lhr-solar/PS-PumpController/readme.md

# PTN-PumpControlBoard
This PCB provides an interface to control the speed of a 12V pump for battery cooling on the 2026 LHR Solar car.
