lhr-solar/PS-PumpController/hardware/PumpController-lib/3d/NVMFWS1D7N04XMT1G.stp

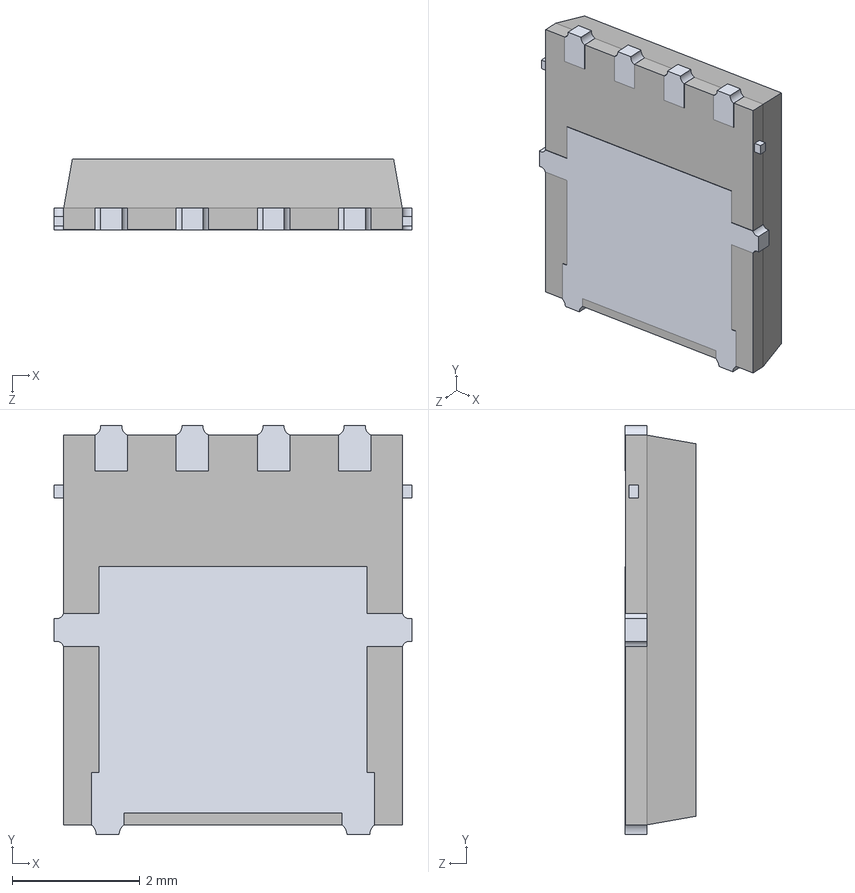
[picture p1: CAD file, 2026-02-16]
hardware/PumpController-lib/3d/NVMFWS1D7N04XMT1G.stp
5.60 x 6.40 x 1.11 mm
