lhr-solar/PS-PumpController/hardware/PumpController-lib/3d/Nano-Fit_2x07_P2.50mm_Vertical.stp

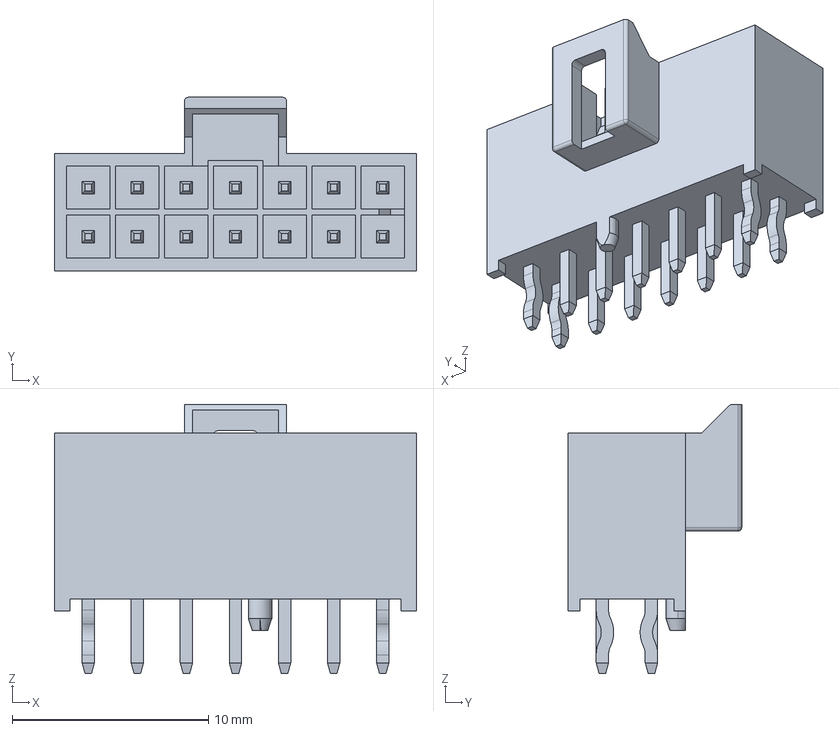
[picture p2: CAD file, 2026-02-16]
hardware/PumpController-lib/3d/Nano-Fit_2x07_P2.50mm_Vertical.stp
18.4 x 8.84 x 13.7 mm
