lhr-solar/PS-PumpController/hardware/PumpController-lib/3d/EMC2305-1-AP-TR.stp

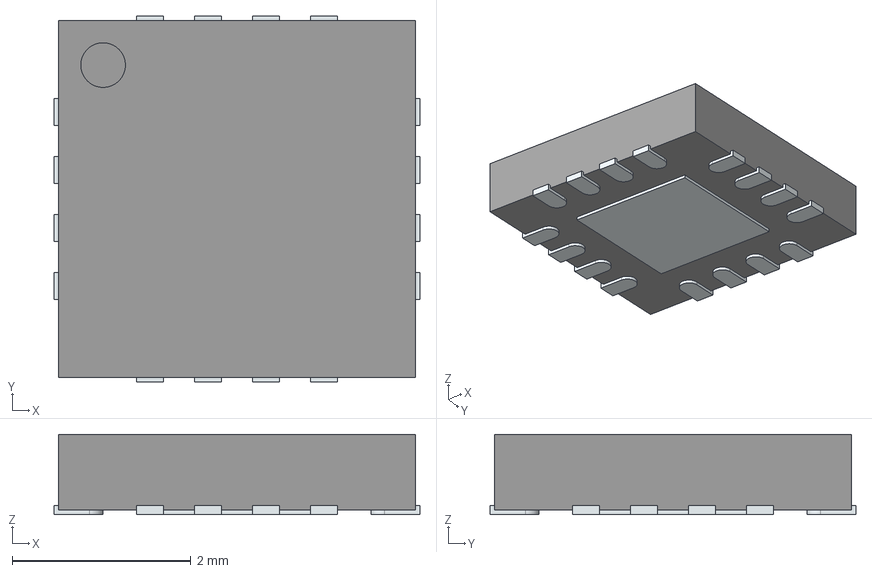
[picture p3: CAD file, 2026-02-16]
hardware/PumpController-lib/3d/EMC2305-1-AP-TR.stp
4.10 x 4.10 x 0.9 mm
ThermalPin
PinsArrayLR
PinsArrayTB
