lhr-solar/PS-PumpController/hardware/PumpController-lib/3d/Nano-Fit_2x03_P2.50mm_Vertical.stp

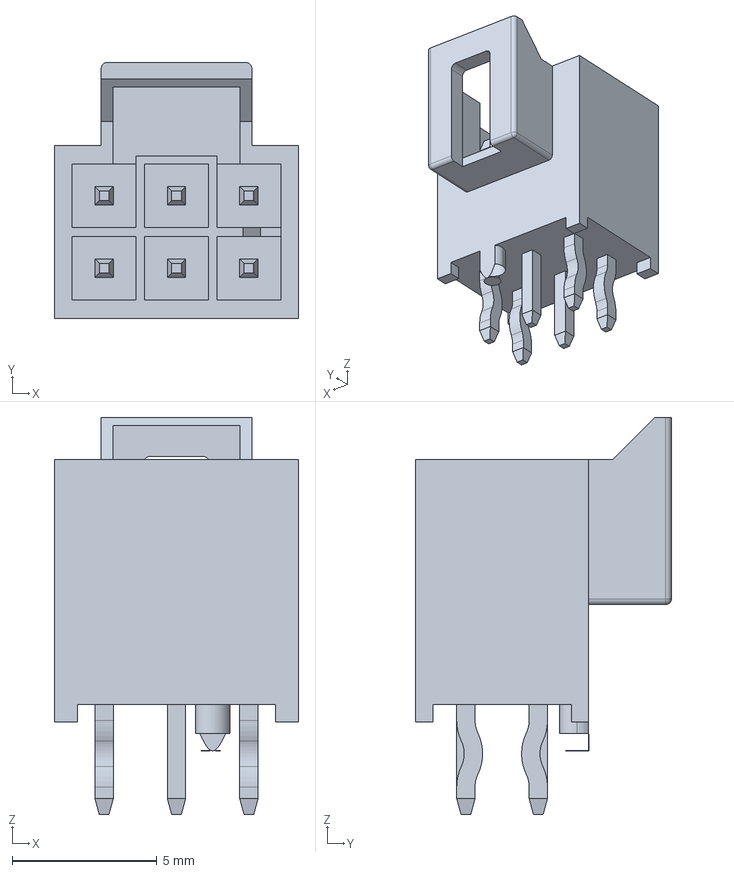
[picture p4: CAD file, 2026-01-15]
hardware/PumpController-lib/3d/Nano-Fit_2x03_P2.50mm_Vertical.stp
8.44 x 8.84 x 13.7 mm
