lhr-solar/PS-PumpController/hardware/PumpController-lib/3d/Nano-Fit_2x06_P2.50mm_Vertical.stp

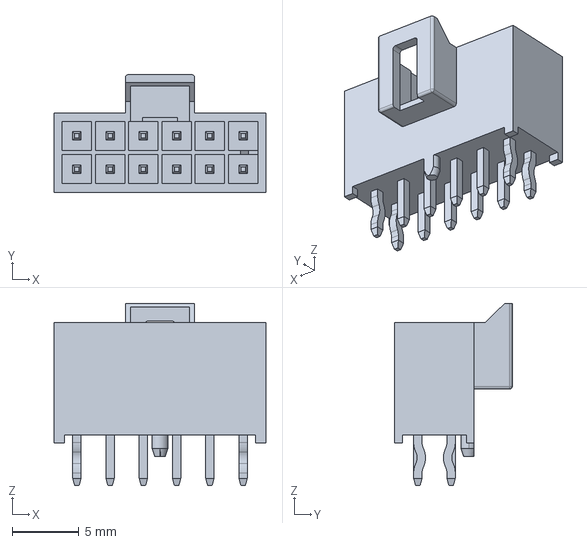
[picture p5: CAD file, 2026-01-15]
hardware/PumpController-lib/3d/Nano-Fit_2x06_P2.50mm_Vertical.stp
15.9 x 8.84 x 13.7 mm
