lhr-solar/PS-PumpController/hardware/PumpController-lib/3d/CR_SOD-123FL_LTF.step

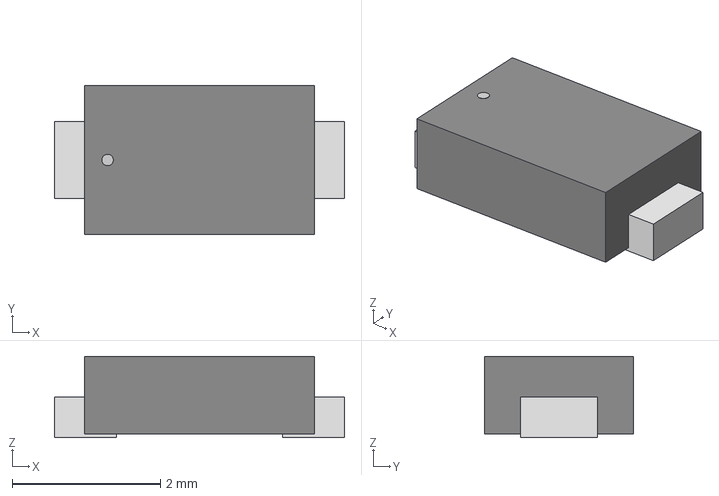
[picture p6: CAD file, 2026-01-15]
hardware/PumpController-lib/3d/CR_SOD-123FL_LTF.step
3.91 x 2.01 x 1.09 mm
