lhr-solar/PS-PumpController/hardware/PumpController-lib/3d/TLV9002QDRQ1.stp

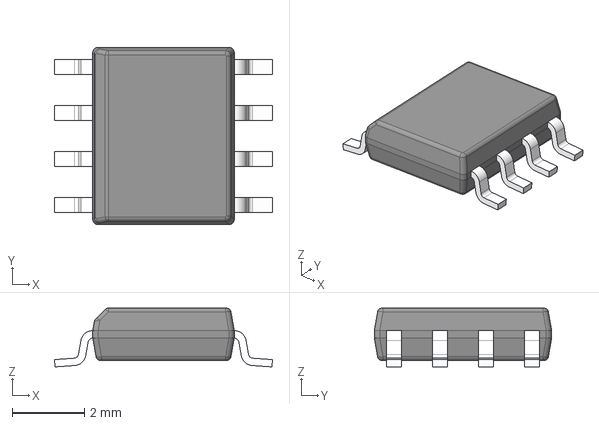
[picture p7: CAD file, 2026-01-15]
hardware/PumpController-lib/3d/TLV9002QDRQ1.stp
6.02 x 4.90 x 1.63 mm
BODY-SO
LEAD-D0008A x 8
