lhr-solar/PS-PumpController/hardware/PumpController-lib/3d/LMR33630ADDA.stp

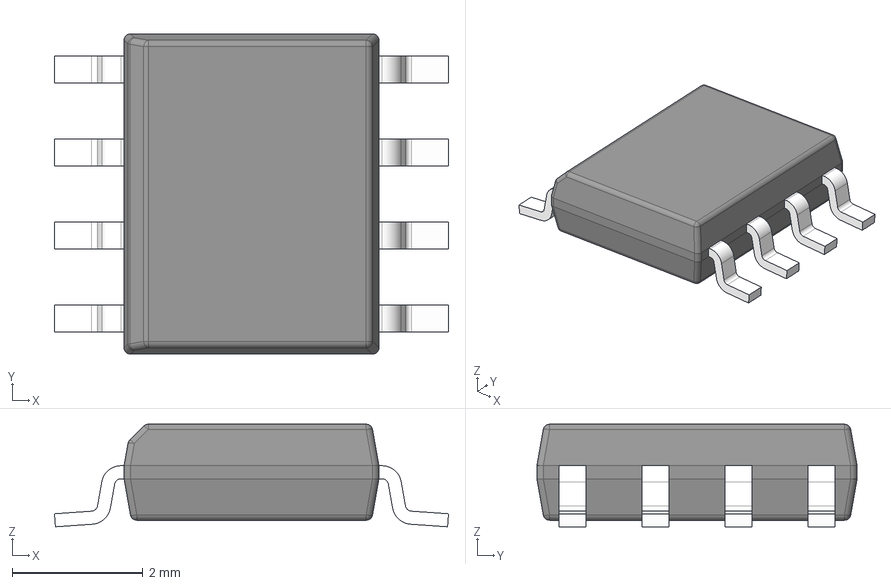
[picture p9: CAD file, 2026-02-16]
hardware/PumpController-lib/3d/LMR33630ADDA.stp
6.03 x 4.90 x 1.57 mm
BODY-SO
LEAD-SO x 8
THERMALPAD-SO
