lhr-solar/PS-PumpController/firmware/core/Inc/pindefs.h

#pragma once

#include "stm32xx_hal.h"

/*.·:·.✧ ✦ ✧.·:·.*.·:·.✧ ✦ ✧.·:·.*.·:·.✧ ✦ ✧.·:·.*.·:·.✧ ✦ ✧.·:·.*.·:·.✧ ✦ ✧.·:·.*/
/*                          FANS + FAN CHIP PINS                                 */
/*.·:·.✧ ✦ ✧.·:·.*.·:·.✧ ✦ ✧.·:·.*.·:·.✧ ✦ ✧.·:·.*.·:·.✧ ✦ ✧.·:·.*.·:·.✧ ✦ ✧.·:·.*/

// Fan pins
#define FAN_I2C_PORT            GPIOB
#define FAN_SCL_PIN             GPIO_PIN_6
#define FAN_SDA_PIN             GPIO_PIN_7
#define FAN_SMBALERT_PIN        GPIO_PIN_12

/*.·:·.✧ ✦ ✧.·:·.*.·:·.✧ ✦ ✧.·:·.*.·:·.✧ ✦ ✧.·:·.*.·:·.✧ ✦ ✧.·:·.*.·:·.✧ ✦ ✧.·:·.*/
/*                               PUMP PINS                                       */
/*.·:·.✧ ✦ ✧.·:·.*.·:·.✧ ✦ ✧.·:·.*.·:·.✧ ✦ ✧.·:·.*.·:·.✧ ✦ ✧.·:·.*.·:·.✧ ✦ ✧.·:·.*/

// Pump pins
#define PUMP_PWM_PORT           GPIOB
#define PUMP_PWM_PIN            GPIO_PIN_15

#define PUMP_TACH_PORT          GPIOA
#define PUMP_TACH_PIN           GPIO_PIN_11

/*.·:·.✧ ✦ ✧.·:·.*.·:·.✧ ✦ ✧.·:·.*.·:·.✧ ✦ ✧.·:·.*.·:·.✧ ✦ ✧.·:·.*.·:·.✧ ✦ ✧.·:·.*/
/*                            TEMP SENSOR PINS                                   */
/*.·:·.✧ ✦ ✧.·:·.*.·:·.✧ ✦ ✧.·:·.*.·:·.✧ ✦ ✧.·:·.*.·:·.✧ ✦ ✧.·:·.*.·:·.✧ ✦ ✧.·:·.*/

// Temp pins
#define TEMP1_ADC_PORT          GPIOA
#define TEMP1_ADC_PIN           GPIO_PIN_4
#define TEMP1_ADC_CHANNEL       ADC_CHANNEL_9
#define TEMP1_SAMPLE_TIME       47

#define TEMP2_ADC_PORT          GPIOA
#define TEMP2_ADC_PIN           GPIO_PIN_5

/*.·:·.✧ ✦ ✧.·:·.*.·:·.✧ ✦ ✧.·:·.*.·:·.✧ ✦ ✧.·:·.*.·:·.✧ ✦ ✧.·:·.*.·:·.✧ ✦ ✧.·:·.*/
/*                            FLOWRATE SENSOR PINS                               */
/*.·:·.✧ ✦ ✧.·:·.*.·:·.✧ ✦ ✧.·:·.*.·:·.✧ ✦ ✧.·:·.*.·:·.✧ ✦ ✧.·:·.*.·:·.✧ ✦ ✧.·:·.*/

// Flowrate pins - timer 2, channel 2
#define FLOW1_TACH_PORT          GPIOB
#define FLOW1_TACH_PIN           GPIO_PIN_3

#define FLOW2_TACH_PORT          GPIOA
#define FLOW2_TACH_PIN           GPIO_PIN_2

/*.·:·.✧ ✦ ✧.·:·.*.·:·.✧ ✦ ✧.·:·.*.·:·.✧ ✦ ✧.·:·.*.·:·.✧ ✦ ✧.·:·.*.·:·.✧ ✦ ✧.·:·.*/
/*                            STATUS LED PINS                                    */
/*.·:·.✧ ✦ ✧.·:·.*.·:·.✧ ✦ ✧.·:·.*.·:·.✧ ✦ ✧.·:·.*.·:·.✧ ✦ ✧.·:·.*.·:·.✧ ✦ ✧.·:·.*/

// LED pins
#define PUMP_LED_PORT           GPIOA
#define PUMP_LED_PIN            GPIO_PIN_0

#define FAN_LED_PORT            GPIOA
#define FAN_LED_PIN             GPIO_PIN_6

#define FANCHIP_LED_PORT        GPIOB
#define FANCHIP_LED_PIN         GPIO_PIN_14

#define FLOW_LED_PORT           GPIOB
#define FLOW_LED_PIN            GPIO_PIN_10

#define TEMP_LED_PORT           GPIOA
#define TEMP_LED_PIN            GPIO_PIN_12

#define PUMP_STATUS_LED_PORT         GPIOB
#define PUMP_STATUS_LED_PIN          GPIO_PIN_0


/*.·:·.✧ ✦ ✧.·:·.*.·:·.✧ ✦ ✧.·:·.*.·:·.✧ ✦ ✧.·:·.*.·:·.✧ ✦ ✧.·:·.*.·:·.✧ ✦ ✧.·:·.*/
/*                                 MISC PINS                                     */
/*.·:·.✧ ✦ ✧.·:·.*.·:·.✧ ✦ ✧.·:·.*.·:·.✧ ✦ ✧.·:·.*.·:·.✧ ✦ ✧.·:·.*.·:·.✧ ✦ ✧.·:·.*/

// LED pins for PSOM
#define STATUS_LED_PORT GPIOA
#define STATUS_LED_PIN_1 GPIO_PIN_7
#define STATUS_LED_PIN_2 GPIO_PIN_8
#define STATUS_LED_PIN_3 GPIO_PIN_15

// USART pins for PSOM
#define USART_PORT GPIOA
#define USART_TX_PIN GPIO_PIN_9
#define USART_RX_PIN GPIO_PIN_10
