lhr-solar/PS-PumpController/firmware/drivers/Src/pumpController.c

#include "PumpController.h"

PumpController_Status_t PumpController_Init() {
    /* HAL_Init should be run before this is called */

    // Init LEDs
    if (LEDs_Init() != LED_OK) return PUMP_CONTROLLER_INIT_FAIL;

    // Init UART printf
    if (mx_uart_init() != true) return PUMP_CONTROLLER_INIT_FAIL;

    // Init TIM2 flowrate
    if (MX_TIM2_Init() != FLOWRATE_OK) return PUMP_CONTROLLER_INIT_FAIL;

    // Init ADC temp sensor
    if (Temp_ADC_Init() != TEMP_OK) return PUMP_CONTROLLER_INIT_FAIL;

    // Init I2C fanchip
    if (MX_I2C1_Init() != FAN_CHIP_OK) return PUMP_CONTROLLER_INIT_FAIL;

    // Init CAN
    if (CAN_Init() != CAN_INIT_OK) return PUMP_CONTROLLER_INIT_FAIL;


    return PUMP_CONTROLLER_OK;
}
