lhr-solar/PS-PumpController/firmware/drivers/Inc/tempTable100k.h

#ifndef TEMP_TABLE_100K_H
#define TEMP_TABLE_100K_H

#include <stdint.h>

// 12-bit ADC Thermistor Lookup Table (Millicelsius)
// Circuit: 3.3V -> 100k Resistor -> ADC Pin -> Thermistor -> GND
// Total elements: 4096
static const int32_t temp_table_100k[4096] = {
    -89990, 527890, 429137, 381888, 352037, 330687, 314292, 301106,
    290151, 280826, 272741, 265626, 259289, 253589, 248417, 243692,
    239348, 235332, 231602, 228123, 224866, 221806, 218923, 216198,
    213616, 211165, 208833, 206609, 204485, 202453, 200506, 198637,
    196841, 195112, 193447, 191842, 190291, 188793, 187344, 185940,
    184580, 183261, 181981, 180737, 179529, 178353, 177209, 176095,
    175009, 173951, 172918, 171910, 170926, 169965, 169026, 168107,
    167209, 166329, 165468, 164625, 163799, 162990, 162196, 161418,
    160655, 159906, 159170, 158448, 157739, 157042, 156357, 155684,
    155023, 154372, 153732, 153102, 152482, 151872, 151272, 150680,
    150098, 149524, 148958, 148401, 147852, 147310, 146776, 146250,
    145730, 145218, 144712, 144213, 143721, 143235, 142755, 142281,
    141813, 141351, 140895, 140444, 139998, 139558, 139123, 138692,
    138267, 137847, 137431, 137020, 136614, 136212, 135814, 135421,
    135031, 134646, 134265, 133888, 133514, 133145, 132779, 132417,
    132058, 131703, 131351, 131003, 130658, 130316, 129978, 129643,
    129310, 128981, 128655, 128332, 128011, 127694, 127379, 127067,
    126758, 126451, 126147, 125846, 125547, 125251, 124957, 124665,
    124376, 124089, 123805, 123523, 123243, 122965, 122689, 122416,
    122145, 121875, 121608, 121343, 121080, 120818, 120559, 120302,
    120046, 119793, 119541, 119291, 119043, 118796, 118551, 118308,
    118067, 117827, 117589, 117353, 117118, 116885, 116653, 116423,
    116194, 115967, 115742, 115518, 115295, 115074, 114854, 114635,
    114418, 114203, 113988, 113775, 113563, 113353, 113144, 112936,
    112729, 112524, 112320, 112117, 111915, 111715, 111515, 111317,
    111120, 110924, 110729, 110535, 110343, 110151, 109961, 109771,
    109583, 109396, 109209, 109024, 108840, 108657, 108474, 108293,
    108113, 107933, 107755, 107577, 107401, 107225, 107050, 106877,
    106704, 106532, 106360, 106190, 106021, 105852, 105684, 105517,
    105351, 105186, 105021, 104858, 104695, 104532, 104371, 104211,
    104051, 103892, 103733, 103576, 103419, 103263, 103108, 102953,
    102799, 102646, 102493, 102341, 102190, 102040, 101890, 101741,
    101592, 101445, 101297, 101151, 101005, 100860, 100715, 100571,
    100428, 100285, 100143, 100001,  99860,  99720,  99580,  99441,
     99303,  99165,  99027,  98890,  98754,  98618,  98483,  98348,
     98214,  98081,  97948,  97815,  97683,  97552,  97421,  97290,
     97160,  97031,  96902,  96774,  96646,  96518,  96391,  96265,
     96139,  96013,  95888,  95764,  95640,  95516,  95393,  95270,
     95148,  95026,  94905,  94784,  94664,  94544,  94424,  94305,
     94186,  94068,  93950,  93832,  93715,  93599,  93483,  93367,
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
};

#endif // TEMP_TABLE_100K_H
