lhr-solar/PS-PumpController/firmware/drivers/Inc/tempTable.h

#ifndef TEMP_TABLE_H
#define TEMP_TABLE_H

#include <stdint.h>

static const int32_t temp_table[4096] = {
120000, 120000, 120000, 120000, 120000, 120000, 120000, 120000, 120000, 120000, 120000, 120000, 120000, 120000, 120000, 120000, 
120000, 120000, 120000, 120000, 120000, 120000, 120000, 120000, 120000, 120000, 120000, 120000, 120000, 120000, 120000, 120000, 
120000, 120000, 120000, 120000, 120000, 120000, 120000, 120000, 120000, 120000, 120000, 120000, 120000, 120000, 120000, 120000, 
120000, 120000, 120000, 120000, 120000, 120000, 120000, 120000, 120000, 120000, 120000, 120000, 120000, 120000, 120000, 120000, 
120000, 120000, 120000, 120000, 120000, 120000, 120000, 120000, 120000, 120000, 120000, 120000, 120000, 120000, 120000, 120000, 
120000, 120000, 120000, 120000, 120000, 120000, 120000, 120000, 120000, 120000, 120000, 120000, 120000, 120000, 120000, 120000, 
120000, 120000, 120000, 120000, 120000, 120000, 120000, 120000, 120000, 120000, 120000, 120000, 120000, 120000, 120000, 120000, 
120000, 120000, 120000, 120000, 120000, 120000, 120000, 120000, 120000, 120000, 120000, 120000, 120000, 120000, 120000, 120000, 
120000, 120000, 120000, 120000, 120000, 120000, 120000, 120000, 120000, 120000, 120000, 120000, 120000, 120000, 120000, 120000, 
120000, 120000, 120000, 120000, 120000, 120000, 120000, 120000, 120000, 120000, 120000, 120000, 120000, 120000, 120000, 120000, 
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
77536, 77470, 77404, 77338, 77272, 77206, 77139, 77073, 77007, 76942, 76877, 76811, 76746, 76680, 76615, 76550, 
76484, 76419, 76354, 76288, 76223, 76158, 76092, 76027, 75963, 75899, 75836, 75772, 75709, 75645, 75582, 75518, 
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
};

#endif
