lhr-solar/PS-PumpController/firmware/drivers/Inc/Fan_I2C.h

#pragma once

#include "pindefs.h"
#include "printf.h"
#include "stm32xx_hal.h"
#include "EMC2305.h"
#include "common.h"

/*.·:·.✧ ✦ ✧.·:·.*.·:·.✧ ✦ ✧.·:·.*.·:·.✧ ✦ ✧.·:·.*.·:·.✧ ✦ ✧.·:·.*.·:·.✧ ✦ ✧.·:·.*/
/*                              FANS + FAN CHIP                                  */
/*.·:·.✧ ✦ ✧.·:·.*.·:·.✧ ✦ ✧.·:·.*.·:·.✧ ✦ ✧.·:·.*.·:·.✧ ✦ ✧.·:·.*.·:·.✧ ✦ ✧.·:·.*/

#define I2C_INTERRUPT_PRIO configLIBRARY_MAX_SYSCALL_INTERRUPT_PRIORITY + 1

// returned by MX_I2C1_Init()
typedef enum FanChip_Status {
    FAN_CHIP_INIT_FAIL,
    FAN_CHIP_OK,
    FAN_CHIP_WRITE_FAIL,
    FAN_CHIP_READ_FAIL,
} FanChip_Status_t;

typedef enum FanChip_Device {
    FAN1,
    FAN2,
    PUMP,
} FanChip_Device_t;

typedef enum FanChip_Mode {
    PWM_MODE,
    FSC_MODE,
} FanChip_Mode_t;

/**
* @brief I2C Initialization Function
* @return FanChip_Status_t indicating failure (0) or success (1) of initialization
*/
FanChip_Status_t MX_I2C1_Init(void);

/**
* @brief I2C Transmit Interrupt Callback
* @param hi2c: pointer to I2C handle structure
*/
void HAL_I2C_MasterTxCpltCallback(I2C_HandleTypeDef* hi2c);

/**
* @brief I2C Recieve Interrupt Callback
* @param hi2c: pointer to I2C handle structure
*/
void HAL_I2C_MasterRxCpltCallback(I2C_HandleTypeDef* hi2c);

/**
* @brief This function handles I2C1 event interrupt.
*/
void I2C1_EV_IRQHandler(void);

/**
* @brief This function handles I2C1 error interrupt.
*/
void I2C1_ER_IRQHandler(void);

/**
* @brief Initializes the fan chip (EMC2305) over I2C, called at the start of fanchip task. Configures the devices as PWM/FSC as set in macros
* @return FanChip_Status_t indicating failure (0) or success (1) of initialization
*/
FanChip_Status_t Cooling_Init(void);


/*.·:·.✧ ✦ ✧.·:·.*.·:·.✧ ✦ ✧.·:·.*.·:·.✧ ✦ ✧.·:·.*.·:·.✧ ✦ ✧.·:·.*.·:·.✧ ✦ ✧.·:·.*/
/*                        PUMP + FANS SPEED TESTING                              */
/*.·:·.✧ ✦ ✧.·:·.*.·:·.✧ ✦ ✧.·:·.*.·:·.✧ ✦ ✧.·:·.*.·:·.✧ ✦ ✧.·:·.*.·:·.✧ ✦ ✧.·:·.*/

// fan control modes
#define FAN_MODE_PWM   0
#define FAN_MODE_FSC   1

// !! CHANGE MODES AS NEEDED !!
#define FAN_MODE        FAN_MODE_PWM
#define PUMP_MODE       FAN_MODE_PWM        // should always be pwm


// Test speeds
#define FAN_TEST_PWM            50
#define FAN_FAULT_PWM           100
#define FAN_TEST_PWM_TARGET     2475 //4950 * (FAN_TEST_PWM/100)
#define FAN_TEST_RPM            3000

#define PUMP_TEST_PWM           100


/*.·:·.✧ ✦ ✧.·:·.*.·:·.✧ ✦ ✧.·:·.*.·:·.✧ ✦ ✧.·:·.*.·:·.✧ ✦ ✧.·:·.*.·:·.✧ ✦ ✧.·:·.*/
/*                  PUMP + FANS SPEED SETPOINTS (REAL)                           */
/*.·:·.✧ ✦ ✧.·:·.*.·:·.✧ ✦ ✧.·:·.*.·:·.✧ ✦ ✧.·:·.*.·:·.✧ ✦ ✧.·:·.*.·:·.✧ ✦ ✧.·:·.*/

// pump temp setpoints (deg C)
#define PUMP_TEMP_MIN        0
#define PUMP_TEMP_SP1        40
#define PUMP_TEMP_SP2        45
#define PUMP_TEMP_SP3        50
#define PUMP_TEMP_MAX        100

// pump speed results
#define PUMP_PWM_SP1        0
#define PUMP_PWM_SP2        100
#define PUMP_PWM_SP3        100
#define PUMP_PWM_SP4        100
