lhr-solar/PS-PumpController/firmware/drivers/Inc/CANbus.h

#pragma once

#include "pindefs.h"
#include "stm32xx_hal.h"
#include "common.h"
#include "CAN.h"
#include "Flowrate.h"
#include "Fan_I2C.h"
#include "Temp.h"
#include "CarCAN_can_msgs.h"
#include <string.h>

/*.·:·.✧ ✦ ✧.·:·.*.·:·.✧ ✦ ✧.·:·.*.·:·.✧ ✦ ✧.·:·.*.·:·.✧ ✦ ✧.·:·.*.·:·.✧ ✦ ✧.·:·.*/
/*                                 CAR CAN BUS                                   */
/*.·:·.✧ ✦ ✧.·:·.*.·:·.✧ ✦ ✧.·:·.*.·:·.✧ ✦ ✧.·:·.*.·:·.✧ ✦ ✧.·:·.*.·:·.✧ ✦ ✧.·:·.*/

#define CAN_INTERRUPT_PRIO configLIBRARY_MAX_SYSCALL_INTERRUPT_PRIORITY

#define PUMP_STATUS_FLOWRATE_DLC        sizeof(pump_status_t)
#define COOLANT_TEMPERATURE_DLC         sizeof(coolant_temperature_t)
#define RADIATOR_FANSPEED_DLC           sizeof(radiator_fanspeed_t)

#define BPS_FAULT_INDEX 0
#define BPS_TEMP_LOW_INDEX 6
#define BPS_TEMP_HIGH_INDEX 5

#define CAN_TX_ITEM_SIZE sizeof(can_tx_payload_t)
#define CAN_TX_QUEUE_LENGTH 20
extern QueueHandle_t can_tx_queue;


typedef struct {
    uint8_t BPS_Fault;
    int16_t Main_Battery_Avg_Temperature;
} bps_status_msg_t;

// returned by CAN_Init()
typedef enum CarCAN_Status {
    CAN_INIT_FAIL,
    CAN_INIT_OK,
    CAN_RECV_FAIL,
    CAN_RECV_OK,
} CarCAN_Status_t;

/**
  * @brief CAN1 Initialization Function
  * @param None
  * @retval None
  */
CarCAN_Status_t CAN_Init(void);

/**
  * @brief CAN MSP Initialization
  * This function configures the hardware resources used in this example
  * @param hcan: CAN handle pointer
  * @retval None
  */
void HAL_CAN_MspInit(CAN_HandleTypeDef* hcan);

/**
  * @brief CAN MSP De-Initialization
  * This function freeze the hardware resources used in this example
  * @param hcan: CAN handle pointer
  * @retval None
  */
void HAL_CAN_MspDeInit(CAN_HandleTypeDef* hcan);

void PackTempCANMessage(CAN_TxHeaderTypeDef* header, TempMsg_t* message, uint8_t tx_data[8]);

void PackFlowrateCANMessage(CAN_TxHeaderTypeDef* header, pump_status_t* FlowMsg, uint8_t tx_data[8]);

void PackFanCANMessage(CAN_TxHeaderTypeDef* header, radiator_fanspeed_t* FanMsg, uint8_t tx_data[8]);

void UnpackBPSStatusMessage(bps_status_msg_t* msg, uint16_t id, const uint8_t rx_data[8]);
