lhr-solar/PS-PumpController/firmware/core/Inc/common.h

#pragma once
#include "stm32xx_hal.h"
#include "UART.h"
#include "printf.h"
#include "pindefs.h"
#include "PumpController.h"

void Error_Handler(void);
void SystemClock_Config(void);
bool mx_uart_init(void);
