lhr-solar/PS-PumpController/firmware/core/Src/common.c

#include "common.h"

void SystemClock_Config(void)
{
  RCC_OscInitTypeDef RCC_OscInitStruct = {0};
  RCC_ClkInitTypeDef RCC_ClkInitStruct = {0};

  /** Configure the main internal regulator output voltage
  */
  if (HAL_PWREx_ControlVoltageScaling(PWR_REGULATOR_VOLTAGE_SCALE1) != HAL_OK)
  {
    Error_Handler();
  }

  /** Initializes the RCC Oscillators according to the specified parameters
  * in the RCC_OscInitTypeDef structure.
  */
  RCC_OscInitStruct.OscillatorType = RCC_OSCILLATORTYPE_HSE;
  RCC_OscInitStruct.HSEState = RCC_HSE_ON;
  RCC_OscInitStruct.PLL.PLLState = RCC_PLL_ON;
  RCC_OscInitStruct.PLL.PLLSource = RCC_PLLSOURCE_HSE;
  RCC_OscInitStruct.PLL.PLLM = 1;
  RCC_OscInitStruct.PLL.PLLN = 20;
  RCC_OscInitStruct.PLL.PLLP = RCC_PLLP_DIV7;
  RCC_OscInitStruct.PLL.PLLQ = RCC_PLLQ_DIV2;
  RCC_OscInitStruct.PLL.PLLR = RCC_PLLR_DIV2;
  if (HAL_RCC_OscConfig(&RCC_OscInitStruct) != HAL_OK)
  {
    Error_Handler();
  }

  /** Initializes the CPU, AHB and APB buses clocks
  */
  RCC_ClkInitStruct.ClockType = RCC_CLOCKTYPE_HCLK|RCC_CLOCKTYPE_SYSCLK
                              |RCC_CLOCKTYPE_PCLK1|RCC_CLOCKTYPE_PCLK2;
  RCC_ClkInitStruct.SYSCLKSource = RCC_SYSCLKSOURCE_PLLCLK;
  RCC_ClkInitStruct.AHBCLKDivider = RCC_SYSCLK_DIV1;
  RCC_ClkInitStruct.APB1CLKDivider = RCC_HCLK_DIV1;
  RCC_ClkInitStruct.APB2CLKDivider = RCC_HCLK_DIV1;

  if (HAL_RCC_ClockConfig(&RCC_ClkInitStruct, FLASH_LATENCY_4) != HAL_OK)
  {
    Error_Handler();
  }
}


void Error_Handler(void) {
    while (1) {
  }
}

bool mx_uart_init(void) {
    // UART init
    GPIO_InitTypeDef InitStruct = { 0 };
    RCC_PeriphCLKInitTypeDef PeriphClkInit = { 0 };

    /** Initializes the peripherals clock
    */
    PeriphClkInit.PeriphClockSelection = RCC_PERIPHCLK_USART1;
    PeriphClkInit.Usart1ClockSelection = RCC_USART1CLKSOURCE_PCLK2;
    if (HAL_RCCEx_PeriphCLKConfig(&PeriphClkInit) != HAL_OK)
    {
        return false;
    }

    /* Peripheral clock enable */
    __HAL_RCC_USART1_CLK_ENABLE();

    __HAL_RCC_GPIOA_CLK_ENABLE();
    /**USART1 GPIO Configuration
    PA9     ------> USART1_TX
    PA10     ------> USART1_RX
    */
    InitStruct.Pin = USART_TX_PIN | USART_RX_PIN;
    InitStruct.Mode = GPIO_MODE_AF_PP;
    InitStruct.Pull = GPIO_NOPULL;
    InitStruct.Speed = GPIO_SPEED_FREQ_VERY_HIGH;
    InitStruct.Alternate = GPIO_AF7_USART1;

    HAL_GPIO_Init(USART_PORT, &InitStruct);

    return true;
}

// huart1.Instance = USART1;
//   huart1.Init.BaudRate = 115200;
//   huart1.Init.WordLength = UART_WORDLENGTH_8B;
//   huart1.Init.StopBits = UART_STOPBITS_1;
//   huart1.Init.Parity = UART_PARITY_NONE;
//   huart1.Init.Mode = UART_MODE_TX_RX;
//   huart1.Init.HwFlowCtl = UART_HWCONTROL_NONE;
//   huart1.Init.OverSampling = UART_OVERSAMPLING_16;
//   huart1.Init.OneBitSampling = UART_ONE_BIT_SAMPLE_DISABLE;
//   huart1.AdvancedInit.AdvFeatureInit = UART_ADVFEATURE_NO_INIT;
//   if (HAL_UART_Init(&huart1) != HAL_OK)
//   {
//     Error_Handler();
//   }
