lhr-solar/PS-PumpController/firmware/drivers/Inc/Flowrate.h

#pragma once

#include "pindefs.h"

#include "stm32xx_hal.h"

/*.·:·.✧ ✦ ✧.·:·.*.·:·.✧ ✦ ✧.·:·.*.·:·.✧ ✦ ✧.·:·.*.·:·.✧ ✦ ✧.·:·.*.·:·.✧ ✦ ✧.·:·.*/
/*                              FLOWRATE SENSOR                                  */
/*.·:·.✧ ✦ ✧.·:·.*.·:·.✧ ✦ ✧.·:·.*.·:·.✧ ✦ ✧.·:·.*.·:·.✧ ✦ ✧.·:·.*.·:·.✧ ✦ ✧.·:·.*/

// returned by MX_TIM2_Init()
typedef enum Flow_Status {
    FLOWRATE_INIT_FAIL,
    FLOWRATE_OK,
    FLOWRATE_READ_FAIL
} Flow_Status_t;

// stores flowrate calculations for each rising edge
typedef struct {
    uint32_t diff;
    uint16_t freq;
    uint16_t flowrate_x10;
} FlowMsg_t;

// converts time between rising edges to frequency in Hz
#define DiffToFreq(x) 1000000 / x

// converts frequency in Hz to 10x flowrate
#define FreqToFlowrate(x) (x * 10) / 11

#define FLOW_INTERRUPT_PRIO configLIBRARY_MAX_SYSCALL_INTERRUPT_PRIORITY + 2

/**
  * @brief TIM2 Initialization Function
  * @return Flow_Status_t indicating failure (0) or success (1) of initialization
  */
Flow_Status_t MX_TIM2_Init(void);

/**
  * @brief TIM2 Interrupt Handler
  */
void TIM2_IRQHandler(void);

/**
  * @brief TIM2 Input Capture Callback, called on rising edge to calculate time diff
  * @param htim: pointer to TIM handle structure
  * @retval None, sends time diff to flowrate queue
  */
void HAL_TIM_IC_CaptureCallback(TIM_HandleTypeDef *htim);

/**
  * @brief Gets time difference value from flowrate queue and converts to 10x flowrate
  * @param message: struct for all flowrate calculations
  * @retval Flow_Status_t indicating failure (2) or success (1) of read
  */
Flow_Status_t Flow_GetReading(FlowMsg_t *message, TickType_t ticksToWait);
