lhr-solar/PS-PumpController/firmware/drivers/Src/therm_table.py

# therm_table.py
# Generates drivers/Inc/TempTable.h

import numpy as np
from pathlib import Path

ADC_MAX = 4095
R_FIXED = 10000.0  # ohms

# Determine output path relative to this script
SCRIPT_DIR = Path(__file__).resolve().parent
OUTPUT_FILE = SCRIPT_DIR.parent / "Inc" / "TempTable.h"

# Temperature (°C), Resistance (kΩ)
raw = """
-40,184.4
-39,174.7
-38,165.6
-37,157.0
-36,149.0
-35,141.3
-34,134.1
-33,127.3
-32,120.9
-31,114.9
-30,109.2
-29,103.7
-28,98.64
-27,93.81
-26,89.24
-25,84.92
-24,80.84
-23,76.97
-22,73.30
-21,69.83
-20,66.55
-19,63.43
-18,60.48
-17,57.68
-16,55.03
-15,52.51
-14,50.12
-13,47.85
-12,45.70
-11,43.66
-10,41.71
-9,39.87
-8,38.12
-7,36.45
-6,34.86
-5,33.36
-4,31.92
-3,30.56
-2,29.26
-1,28.02
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
"""

pairs = []
for line in raw.strip().splitlines():
    t, r = line.split(",")
    pairs.append((float(t), float(r) * 1000.0))

temps = np.array([p[0] for p in pairs])
R = np.array([p[1] for p in pairs])

adc_pts = ADC_MAX * R / (R_FIXED + R)

adc_values = np.arange(ADC_MAX + 1)
adc_to_temp = np.interp(adc_values, adc_pts[::-1], temps[::-1])

adc_to_temp_mc = np.round(adc_to_temp * 1000).astype(int)

# Write header (overwrite if exists)
with open(OUTPUT_FILE, "w") as f:
    f.write("#ifndef TEMP_TABLE_H\n")
    f.write("#define TEMP_TABLE_H\n\n")
    f.write("#include <stdint.h>\n\n")
    f.write("static const int32_t temp_table[4096] = {\n")

    for i, val in enumerate(adc_to_temp_mc):
        f.write(f"{val}, ")
        if (i + 1) % 16 == 0:
            f.write("\n")

    f.write("};\n\n")
    f.write("#endif\n")

print(f"Generated {OUTPUT_FILE}")
