lhr-solar/PS-PumpController/firmware/tests/blinky_test.c

/*.·:·.✧ ✦ ✧.·:·.*.·:·.✧ ✦ ✧.·:·.*.·:·.✧ ✦ ✧.·:·.*.·:·.✧ ✦ ✧.·:·.*.·:·.✧ ✦ ✧.·:·.*/
/*              BLINKY TEST: Blinks every LED in sequence then loops             */
/*.·:·.✧ ✦ ✧.·:·.*.·:·.✧ ✦ ✧.·:·.*.·:·.✧ ✦ ✧.·:·.*.·:·.✧ ✦ ✧.·:·.*.·:·.✧ ✦ ✧.·:·.*/

#include "tasks.h"

StaticTask_t xBlinkyTaskBuffer;
StackType_t xBlinkyStack[configMINIMAL_STACK_SIZE];

int main(void) {

    if (HAL_Init() != HAL_OK) Error_Handler();
    SystemClock_Config();
    __HAL_RCC_SYSCFG_CLK_ENABLE();
    __HAL_RCC_PWR_CLK_ENABLE();

    if (PumpController_Init() != PUMP_CONTROLLER_OK) Error_Handler();
    HAL_GPIO_TogglePin(TEMP_LED_PORT, TEMP_LED_PIN);

    // Create tasks
    
    xTaskCreateStatic(
        Blinky_Task,
        "Blinky",
        configMINIMAL_STACK_SIZE,
        NULL,
        BLINKY_TASK_PRIO,
        xBlinkyStack,
        &xBlinkyTaskBuffer
    );

    vTaskStartScheduler();

    while (1) {
    }

    return 0;
}
