lhr-solar/PS-PumpController/(commit log)

2025-03-01 initial kicad stuff
    [PTN-PumpControlBoard.kicad_pcb, PTN-PumpControlBoard.kicad_sch]
2025-09-12 RevA (#1)
    * Initial schematic with 3 temp, 1 flow, 1 pump, 2 fans
    * Added pull up resistors for open drain configs
    * Initial schematic design with 2 temp, 1 flow, 1 pump
    * Initial layout with 1 pump, 2 temp, 1 flow all on front side
    * modified labels, added mounting holes, and rounded corners
    * schematic with 12V components, unigain buffers & extra temp sensor
    * repicked parts to be 24V tolerant and changed corresponding circuitry
    * reworked layout with 24V components but no testpoints & headers
    * added test points and headers, AGND and 12V not fully connected
    * fixed VDDA and 24V but 3.3V and AGND still not working
    * filled zones finally workinggggg
    * making in prettyyy (kinda)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
    [Fans.kicad_sch, FlowrateSensor.kicad_sch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]
2025-10-11 fixed rpp
    [PowerProtection.kicad_sch]
2026-01-15 Rev B (#2)
    * initial schem changes
    * major schem fixes
    * schem review changes
    * finalized schem
    * almost all footprints
    * idk what I changed but pushing jic
    * subcircuit layout
    * mx150 version
    * main circuitry done
    * it's almost prettyyy
    * lakshays bs
    * jic
    * almost there
    * lookin cute
    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
    [CR_SOD-123FL_LTF.step, Fans+Pump.kicad_sch, Fans.kicad_sch, FlowrateSensor.kicad_sch, Nano-Fit_2x03_P2.50mm_Vertical.stp, Nano-Fit_2x04_P2.50mm_Vertical.stp, Nano-Fit_2x06_P2.50mm_Vertical.stp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]
2026-02-16 Rev c (#4)
    * making sure submodules are right
    * deleting stuff
    * more deletes
    * last delete (?)
    * hopefully fixed?
    * gerbers
    * fixed 3d models
    * fix .gitignore
    Add various entries to .gitignore for build files, Python environments, Mac specific files, Vim swap files, Nix lock files, documentation toolset, and VSCode settings.
    * .gitmodules fix
    * hopefully firmware setup works?
    [EMC2305-1-AP-TR.stp, LMR33630ADDA.stp, NVMFWS1D7N04XMT1G.stp, Nano-Fit_2x07_P2.50mm_Vertical.stp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]
2026-03-09 Drivers (#3)
    * basic firmware setup but blinky no work yet
    * fixed submodule issue
    * added workflows from vcu
    * initial led driver
    * better organization:
    * it compilesgit status
    * fixed blinky_test
    * test description
    * move led_configs to header
    * workflows?
    * added cubemx code
    * some semblance of fan driver but doesn't compile rip
    * compiling fan test
    * fixing review stuff
    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
    [PTN-PumpControlBoard.kicad_sch]
2026-03-28 flowrate can send but not tested
2026-04-16 doesn't work but I wanna push it somewhere
    [CANbus.c, CANbus.h, Fan_I2C.h, can_test.c, fans_tasks.c, init_task.c, mvp_pump_test.c]
2026-07-16 pump control loop compiles, tbd if it works
